Hobbyhobbit/BikeFromHell/README

see the project documentation which can be found at

http://people.ee.ethz.ch/~andstein/bfh/
