Hobbyhobbit/BikeFromHell/links.txt

color cycling
  - http://www.effectgames.com/demos/canvascycle/?sound=0

bluetooth modules
  - http://www.goodluckbuy.com/serial-bluetooth-rf-transceiver-module-rs232.html

SMD LEDs
  - unicolored, reichelt
