Hobbyhobbit/BikeFromHell/documentation/energy.rst

***************************
Energy/Power Considerations
***************************

Batteries
=========

  - `triple A batteries`_
    
    - up to 1200 mAh (Alkaline LR03, Lithium FR03)
    - relatively small discharge current

.. _triple A batteries: http://en.wikipedia.org/wiki/AAA_battery
