Hobbyhobbit/BikeFromHell/documentation/index.rst

.. Bike From Hell documentation master file, created by
   sphinx-quickstart on Sat Mar 10 12:53:52 2012.
   You can adapt this file completely to your liking, but it should at least
   contain the root `toctree` directive.

Bike From Hell Documentation
============================

This document describes various aspects of the project, such as information
on required hardware, implementation details, design guidelines etc...

.. toctree::
   :maxdepth: 3

   parts.rst
   speed.rst
   bluetooth.rst
   userinterface.rst
   prototypes.rst
   energy.rst
   notes.rst

TODO
====

.. todolist::
