Hobbyhobbit/BikeFromHell/artwork/prototype1_naked.jpg

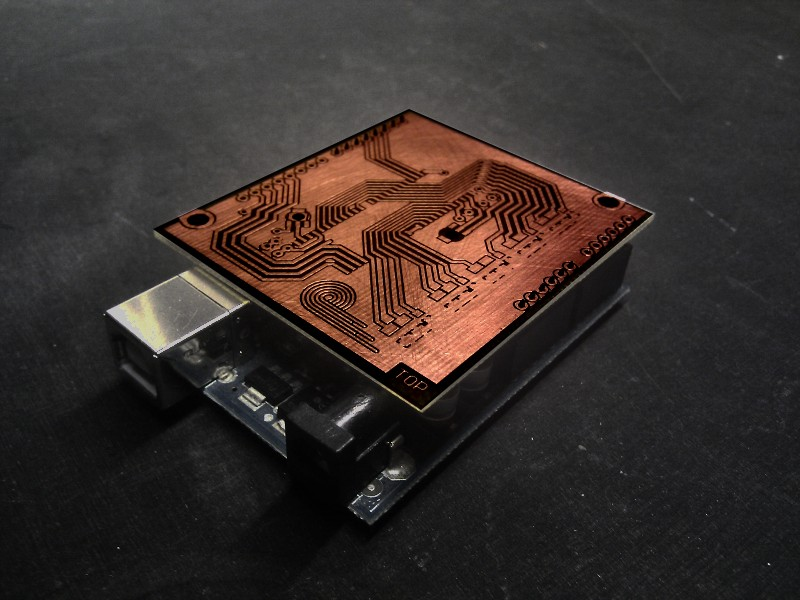
artwork/prototype1_naked.jpg
