Hobbyhobbit/BikeFromHell/sketches/BikeFromHell/patterns/eye.jpeg

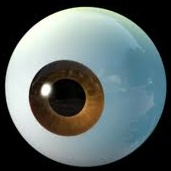
sketches/BikeFromHell/patterns/eye.jpeg
