Hobbyhobbit/BikeFromHell/sketches/BikeFromHell/patterns/nein_danke.gif

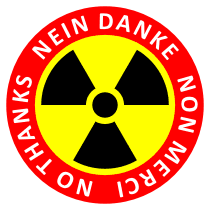
sketches/BikeFromHell/patterns/nein_danke.gif
