Hobbyhobbit/BikeFromHell/sketches/BikeFromHell/patterns/spectrum.png

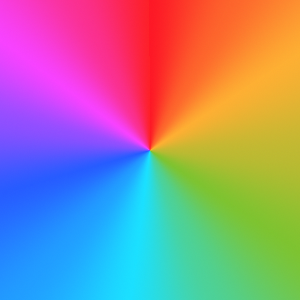
sketches/BikeFromHell/patterns/spectrum.png
