Hobbyhobbit/BikeFromHell/hardware/eagle/prototype1/Prototype1.pdf

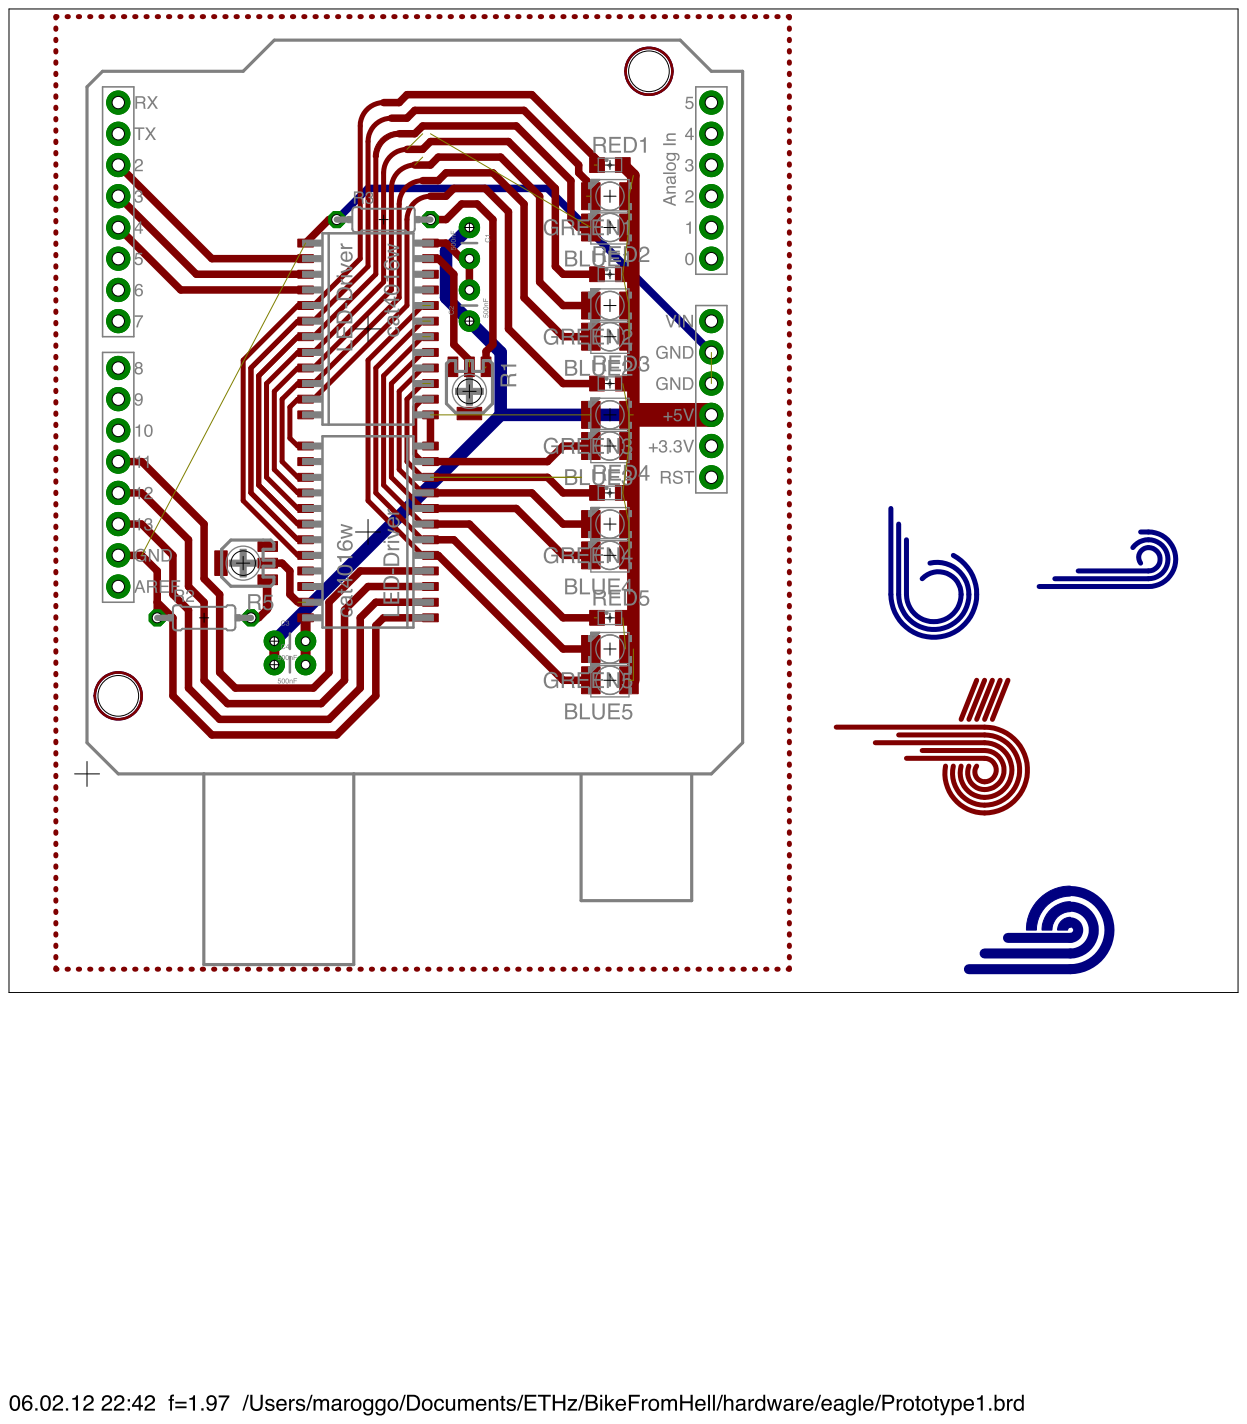
[picture p7: page 1]
