Hobbyhobbit/BikeFromHell/(list of files, drawings)

Other design files:
hardware/geda/prototooth/prototooth.pcb
hardware/geda/prototype3/b_lines_scaled.pcb
hardware/geda/prototype3/prototype3.pcb
hardware/geda/res/arduino-shield.pcb
