Hobbyhobbit/BikeFromHell/hardware/eagle/prototype2/Prototype2.brd

## EAGLE design hardware/eagle/prototype2/Prototype2.brd (2012-07-21)

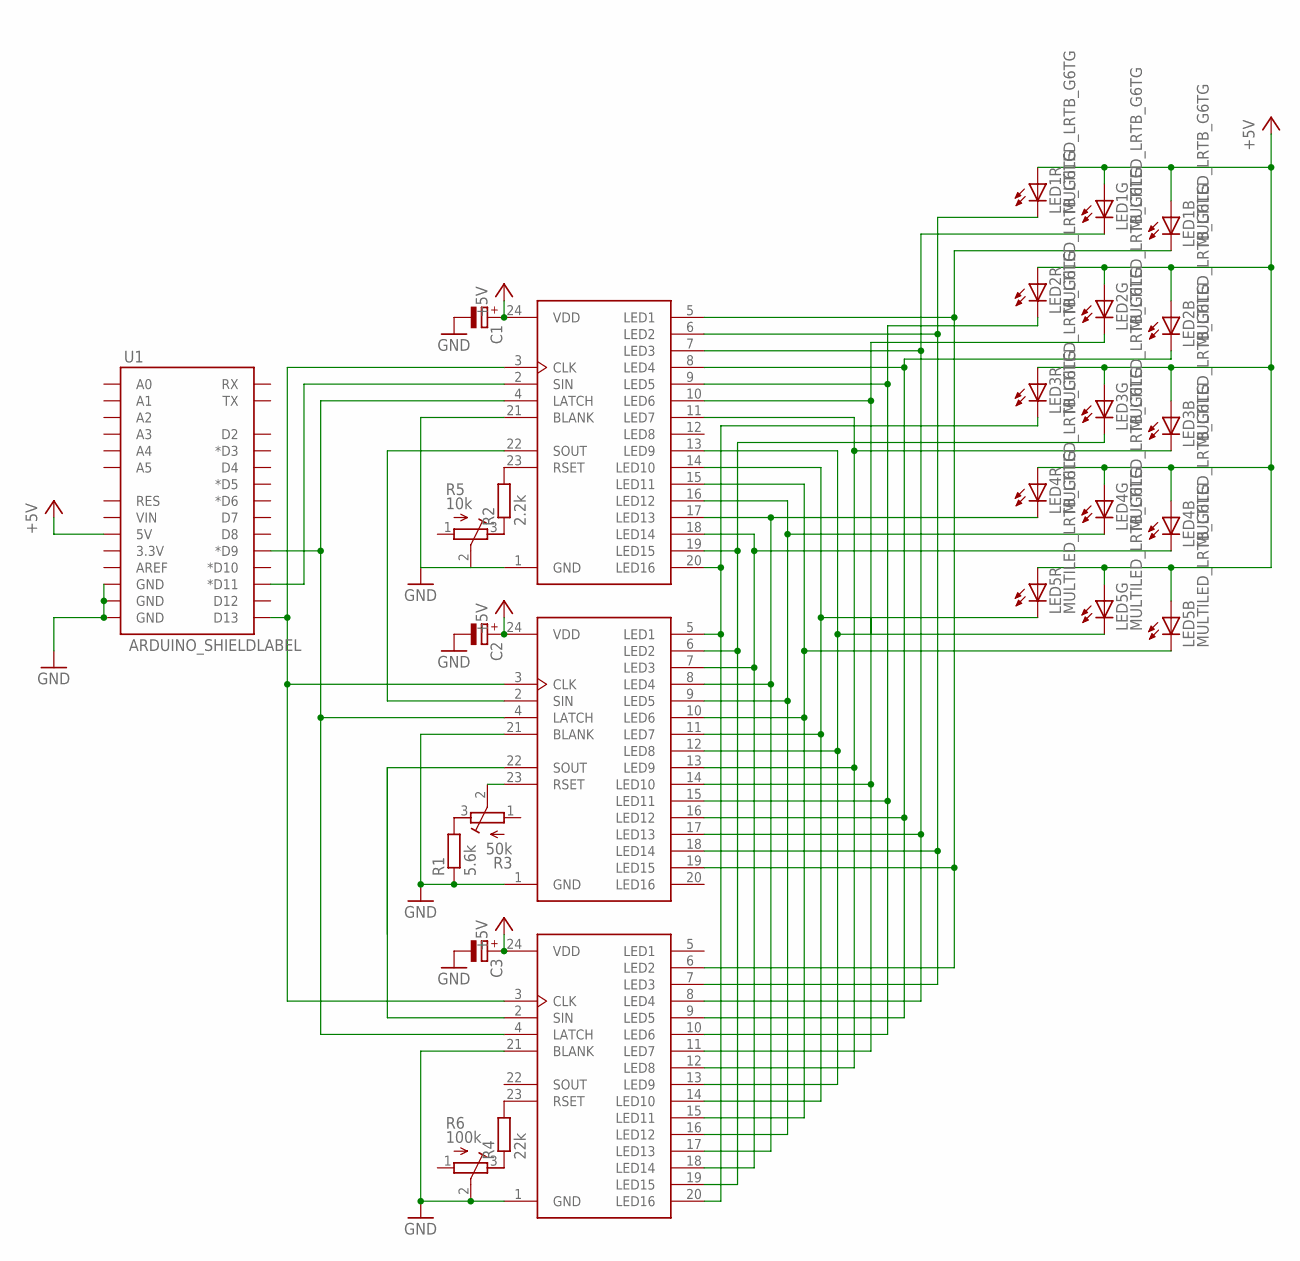
[picture p8: schematic Prototype2.sch]

Parts:
C1, C2, C3: CPOL-EUA/3216-18W; A/3216-18W
LED1, LED2, LED3, LED4, LED5: MULTILED_LRTB_G6TG; P-LCC-6_TOPLED
R1: 5.6k; 0204/7
R2: 2.2k; 0204/7
R3: 50k; RTRIM3165W
R4: 22k; 0204/7
R5: 10k; RTRIM3165W
R6: 100k; RTRIM3165W
U1: ARDUINO_SHIELDLABEL; DUEMILANOVE_SHIELD
U$1, U$2, U$3: CAT4016; SOIC24W

Connections:
+5V: C1.+, C2.+, C3.+, LED1.A1 (A), LED1.A2 (A), LED1.A3 (A), LED2.A1 (A), LED2.A2 (A), LED2.A3 (A), LED3.A1 (A), LED3.A2 (A), LED3.A3 (A), LED4.A1 (A), LED4.A2 (A), LED4.A3 (A), LED5.A1 (A), LED5.A2 (A), LED5.A3 (A), U1.5V, U$1.24 (VDD), U$2.24 (VDD), U$3.24 (VDD)
GND: C1.-, C2.-, C3.-, R1.1, R5.2 (S), R6.2 (S), U1.GND@0 (GND), U1.GND@1 (GND), U1.GND@2 (GND), U$1.1 (GND), U$1.21 (BLANK), U$2.1 (GND), U$2.21 (BLANK), U$3.1 (GND), U$3.21 (BLANK)
unnamed: R2.2, U$3.23 (RSET)
unnamed: R2.1, R5.3 (E)
unnamed: R4.2, U$2.23 (RSET)
unnamed: U$1.2 (SIN), U$3.22 (SOUT)
unnamed: U1.D11 (*D11), U$3.2 (SIN)
unnamed: U1.D9 (*D9), U$1.4 (LATCH), U$2.4 (LATCH), U$3.4 (LATCH)
unnamed: R4.1, R6.3 (E)
unnamed: R1.2, R3.3 (E)
unnamed: R3.2 (S), U$1.23 (RSET)
unnamed: U$1.22 (SOUT), U$2.2 (SIN)
unnamed: U1.D13, U$1.3 (CLK), U$2.3 (CLK), U$3.3 (CLK)
unnamed: LED5.C2 (C), U$1.12 (LED8), U$2.13 (LED9), U$3.13 (LED9)
unnamed: LED5.C1 (C), U$1.11 (LED7), U$2.14 (LED10), U$3.14 (LED10)
unnamed: LED5.C3 (C), U$1.10 (LED6), U$2.15 (LED11), U$3.15 (LED11)
unnamed: LED4.C2 (C), U$1.9 (LED5), U$2.16 (LED12), U$3.16 (LED12)
unnamed: LED4.C1 (C), U$1.8 (LED4), U$2.17 (LED13), U$3.17 (LED13)
unnamed: LED4.C3 (C), U$1.7 (LED3), U$2.18 (LED14), U$3.18 (LED14)
unnamed: LED3.C2 (C), U$1.6 (LED2), U$2.19 (LED15), U$3.19 (LED15)
unnamed: LED3.C3 (C), U$1.13 (LED9), U$2.12 (LED8), U$3.11 (LED7)
unnamed: LED2.C2 (C), U$1.14 (LED10), U$2.11 (LED7), U$3.10 (LED6)
unnamed: LED2.C1 (C), U$1.15 (LED11), U$2.10 (LED6), U$3.9 (LED5)
unnamed: LED2.C3 (C), U$1.16 (LED12), U$2.9 (LED5), U$3.8 (LED4)
unnamed: LED1.C2 (C), U$1.17 (LED13), U$2.8 (LED4), U$3.7 (LED3)
unnamed: LED1.C1 (C), U$1.18 (LED14), U$2.7 (LED3), U$3.6 (LED2)
unnamed: LED1.C3 (C), U$1.19 (LED15), U$2.6 (LED2), U$3.5 (LED1)
unnamed: LED3.C1 (C), U$1.5 (LED1), U$2.20 (LED16), U$3.20 (LED16)

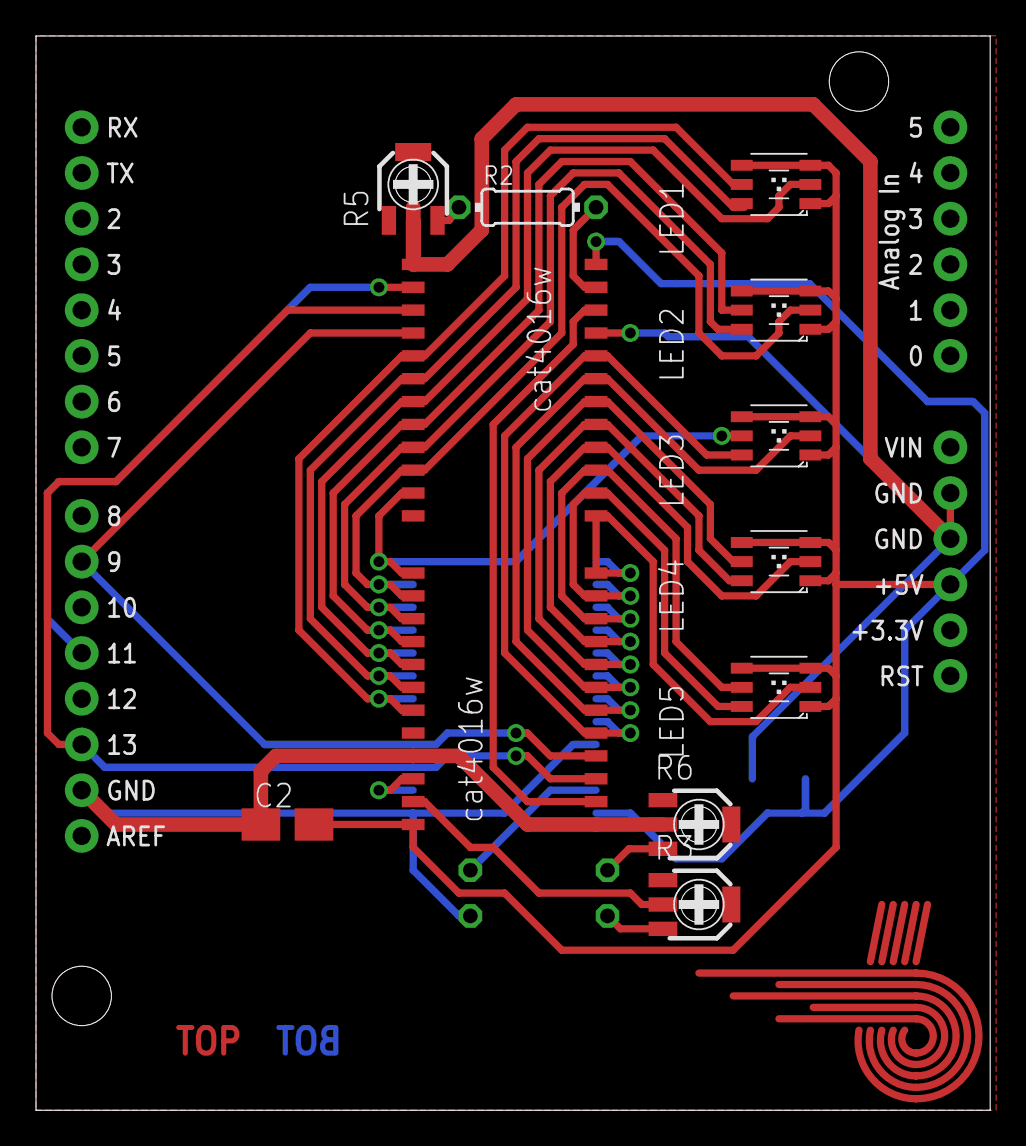
[picture p9: board Prototype2.brd from above]

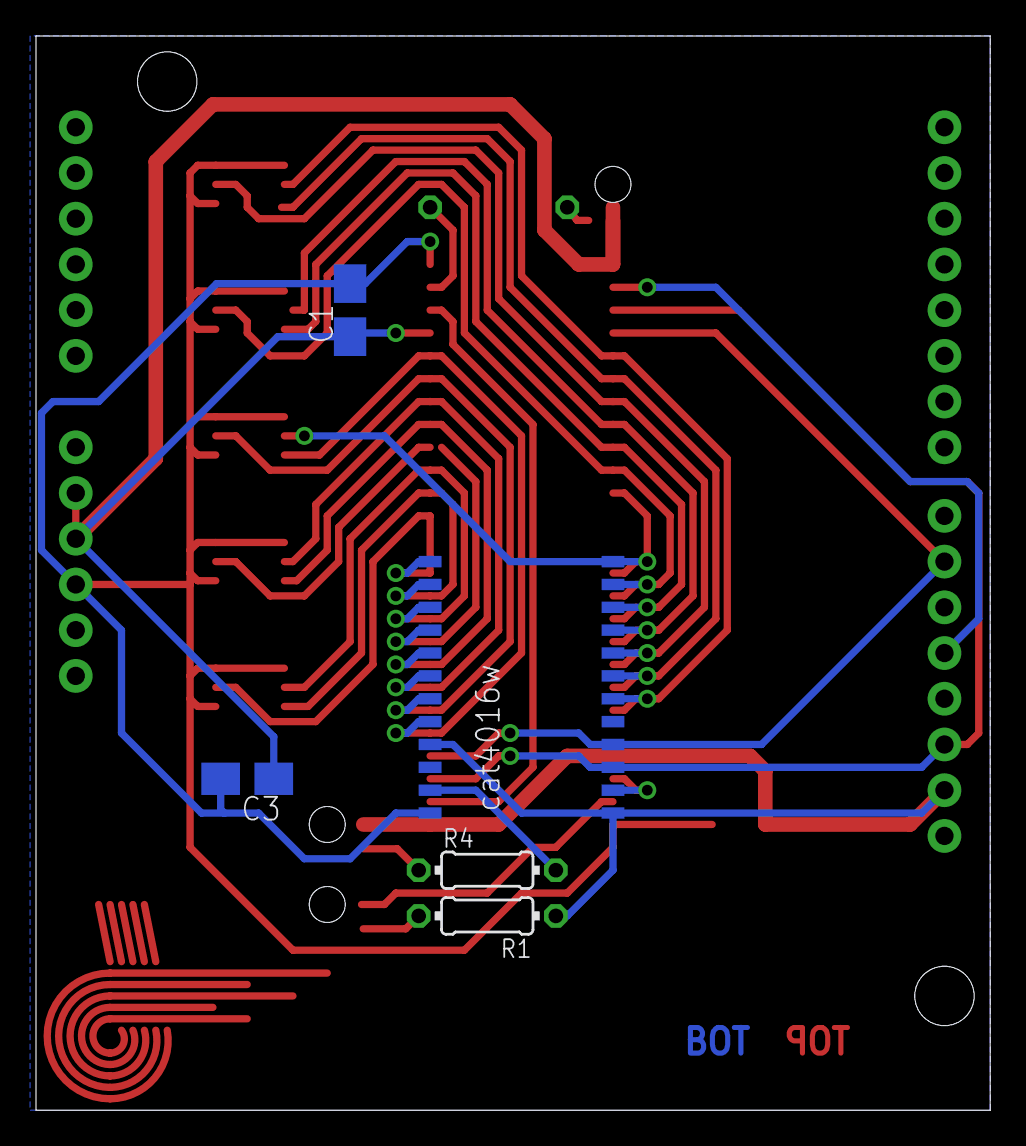
[picture p10: board Prototype2.brd from below]

Board: 2 copper layers, 53.0 x 59.7 mm, 18 parts (5 on the bottom side), 28 nets.
