Hobbyhobbit/BikeFromHell/hardware/eagle/prototype1/Prototype1.brd

## EAGLE design hardware/eagle/prototype1/Prototype1.brd (2012-02-19, an earlier design)

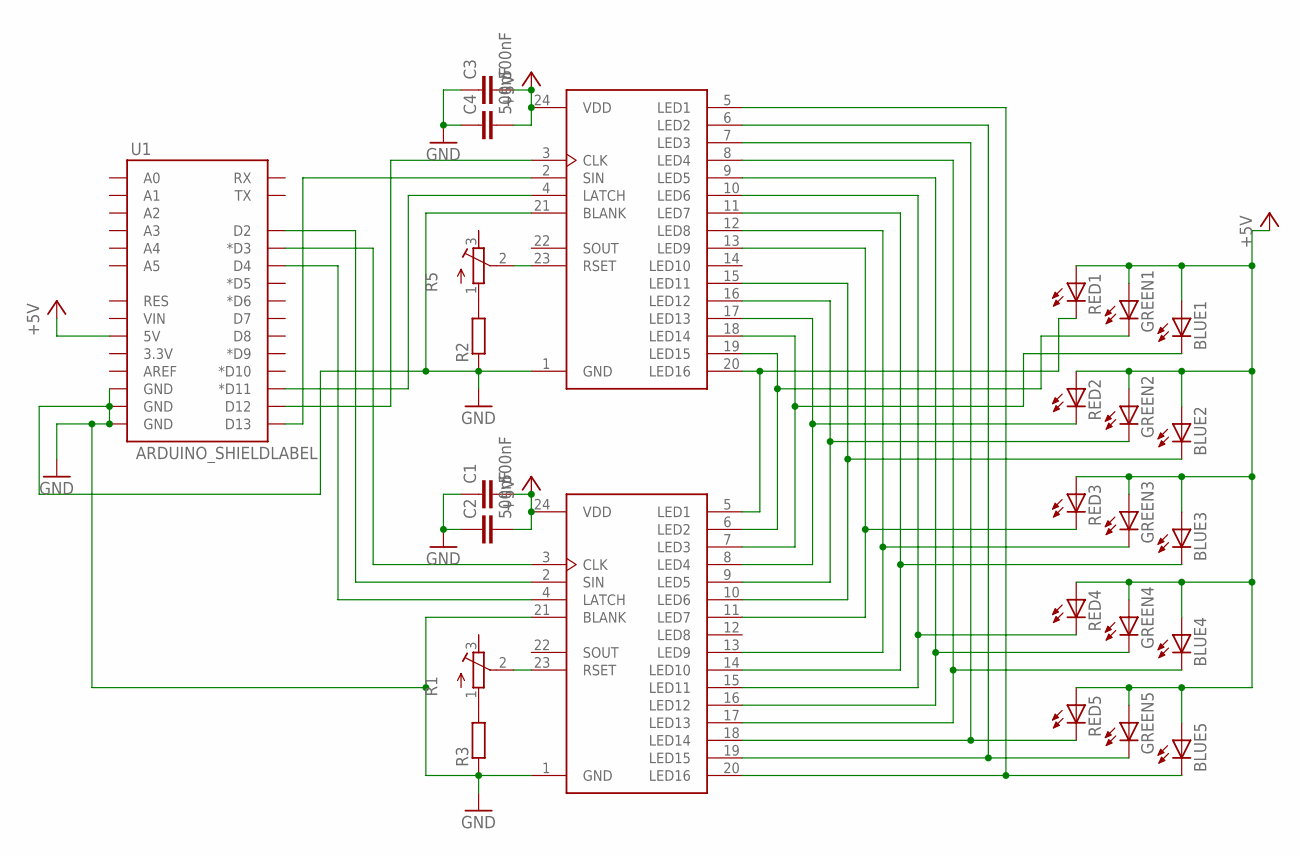
[picture p11: schematic Prototype1.sch]

Parts:
BLUE1, BLUE2, BLUE3, BLUE4, BLUE5: LEDKA-3528ASYC; KA-3528ASYC
C1, C2, C3, C4: 500nF; CAP-PTH-SMALL
GREEN1, GREEN2, GREEN3, GREEN4, GREEN5: LEDKA-3528ASYC; KA-3528ASYC
R1, R5: R-TRIMM3165W; RTRIM3165W
R2, R3: R-EU_0204/7; 0204/7
RED1, RED2, RED3, RED4, RED5: LEDSML0805; SML0805
U1: ARDUINO_SHIELDLABEL; DUEMILANOVE_SHIELD
U$2, U$3: CAT4016; SOIC24W

Connections:
+5V: BLUE1.A, BLUE2.A, BLUE3.A, BLUE4.A, BLUE5.A, C1.2, C2.2, C3.2, C4.2, GREEN1.A, GREEN2.A, GREEN3.A, GREEN4.A, GREEN5.A, RED1.A, RED2.A, RED3.A, RED4.A, RED5.A, U1.5V, U$2.24 (VDD), U$3.24 (VDD)
GND: C1.1, C2.1, C3.1, C4.1, R2.1, R3.1, U1.GND@0 (GND), U1.GND@1 (GND), U1.GND@2 (GND), U$2.1 (GND), U$2.21 (BLANK), U$3.1 (GND), U$3.21 (BLANK)
unnamed: R1.1 (A), R3.2
unnamed: R2.2, R5.1 (A)
unnamed: R1.2 (S), U$2.23 (RSET)
unnamed: R5.2 (S), U$3.23 (RSET)
unnamed: U1.D3 (*D3), U$2.3 (CLK)
unnamed: U1.D4, U$2.4 (LATCH)
unnamed: U1.D13, U$3.2 (SIN)
unnamed: U1.D2, U$2.2 (SIN)
unnamed: GREEN2.C, U$2.9 (LED5), U$3.16 (LED12)
unnamed: RED2.C, U$2.8 (LED4), U$3.17 (LED13)
unnamed: BLUE1.C, U$2.7 (LED3), U$3.18 (LED14)
unnamed: GREEN1.C, U$2.6 (LED2), U$3.19 (LED15)
unnamed: BLUE2.C, U$2.10 (LED6), U$3.15 (LED11)
unnamed: RED1.C, U$2.5 (LED1), U$3.20 (LED16)
unnamed: RED3.C, U$2.11 (LED7), U$3.13 (LED9)
unnamed: GREEN3.C, U$2.13 (LED9), U$3.12 (LED8)
unnamed: BLUE3.C, U$2.14 (LED10), U$3.11 (LED7)
unnamed: RED4.C, U$2.15 (LED11), U$3.10 (LED6)
unnamed: GREEN4.C, U$2.16 (LED12), U$3.9 (LED5)
unnamed: BLUE4.C, U$2.17 (LED13), U$3.8 (LED4)
unnamed: RED5.C, U$2.18 (LED14), U$3.7 (LED3)
unnamed: GREEN5.C, U$2.19 (LED15), U$3.6 (LED2)
unnamed: U1.D12, U$3.3 (CLK)
unnamed: U1.D11 (*D11), U$3.4 (LATCH)
unnamed: BLUE5.C, U$2.20 (LED16), U$3.5 (LED1)

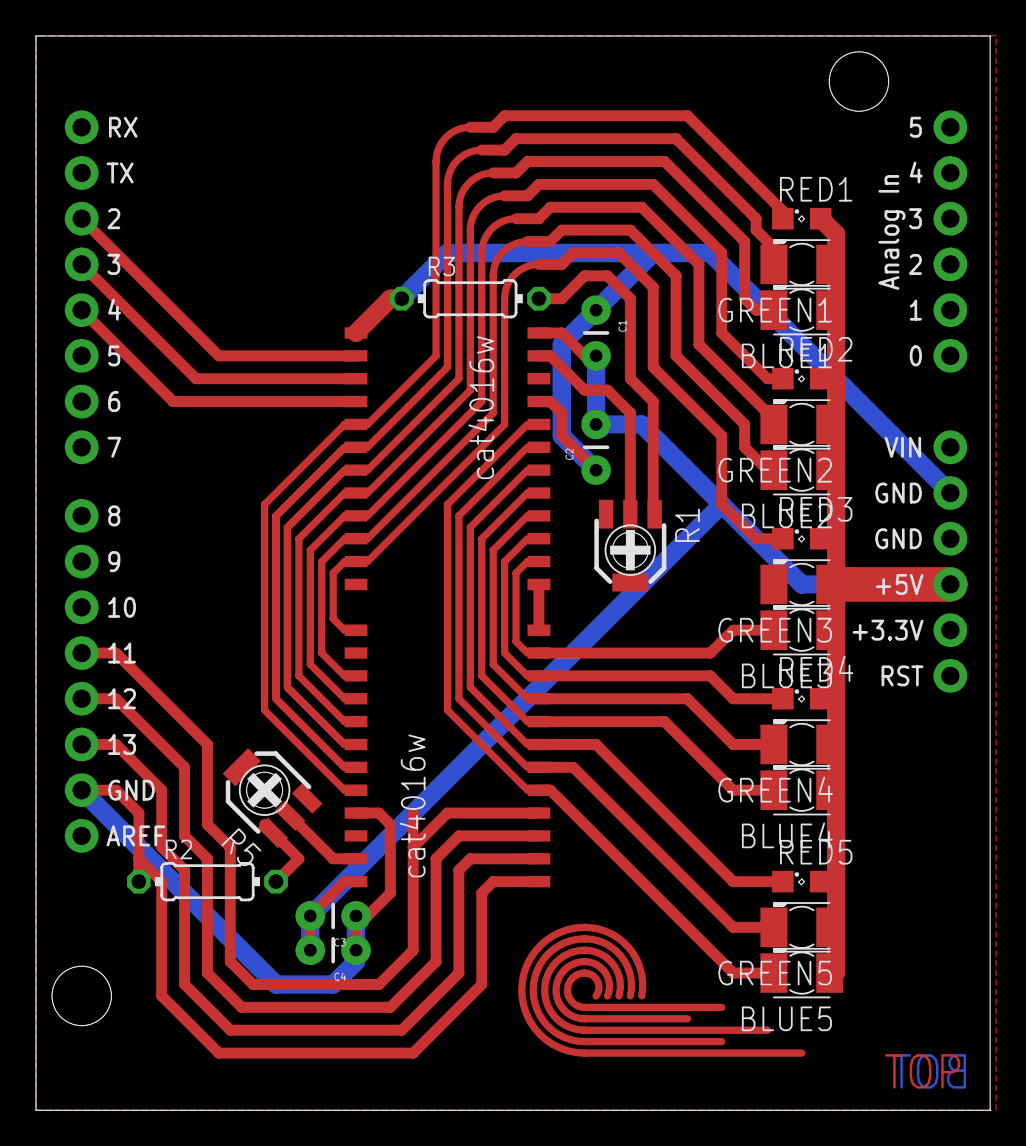
[picture p12: board Prototype1.brd from above]

Board: 2 copper layers, 53.0 x 59.7 mm, 26 parts (0 on the bottom side), 27 nets.
