Hobbyhobbit/BikeFromHell/sketches/BikeFromHell/BikeFromHell.pde

import controlP5.*;

int things= 1;
int leds= 5;
int resolution= 10; // slots per turn
//int leds= 16;
//int resolution= 100; // slots per turn
float kmh= 10f; // bicycle speed
float smear=.5f; // how long lights are visible
float wheelR=.4f; // wheel radius

final static int RUNNING= 0;
final static int IMAGING= 1;
int mode = RUNNING;
SpinningWheel spinningWheel;
ImageWheel    imageWheel;
Prototype1Serializer serializer;

float pos1= 0f, pos2= 0f; // grow continuously; +1/turn
float dpos= 0f; // adapted depending on actual fps
float delta= 0f;
int fps= 60; // will be adjusted to actual value
Textlabel fpsLabel;
int mstart,lastframe,frames;
ControlP5 cp5;
LedMatrix matrix;
int ledMax=4; // resolution of every LED; e.g. 4 means 2 bits
int ledRed,ledGreen,ledBlue; // active color in matrix

// create new .matrix files : press "d" and copy'n'paste into data/ directory
String[] dataFiles;

void setup() {
  size(800,400);
  cp5= new ControlP5(this);
  // general parameters
  cp5.addSlider("kmh"  ,0f,30f, 560,100,10,100);
  cp5.addSlider("smear",0f, 1f, 600,100,10,100);
  cp5.addSlider("delta",0f,.2f, 640,100,10,100);
  
  // file controls
  // won't work in applet
  File dataDir= new File(sketchPath+"/patterns");
  dataFiles = dataDir.list();

  ListBox fileList= cp5.addListBox("fileList", 680,100,100,200);
  for(int i=0; i<dataFiles.length; i++){
    if (dataFiles[i].charAt(0) != '.')
      fileList.addItem( dataFiles[i],i );
  }
  
  // color pickers
//  cp = new ColorPicker( 20, 60, 200, 200, 255 );
  colorSlider("ledRed"  ,#FF0000,  0,290,60,10);
  colorSlider("ledGreen",#00FF00, 80,290,60,10);
  colorSlider("ledBlue" ,#0000FF,160,290,60,10);
  
  // led matrix
  matrix= new LedMatrix("ledCode",ledMax,resolution,leds,0,300,800,100);
  
  // wheel controls
  fpsLabel= cp5.addTextlabel("fps","?? FPS",760,290);
  spinningWheel= new SpinningWheel( width/2,150,100,20,matrix );
  imageWheel   = new ImageWheel   ( width/2,150,100,20,matrix );
  
  // arduino connection
  serializer= new Prototype1Serializer();
  cp5.addButton("flash",0,700,290,50,10);

  frameRate(fps);
  mstart= millis();
  lastframe= frames= 0;
  
  background(0);
}


void draw() {
  // clear background of controls
  fill(0);
  rect(0  ,0,150,300);
  rect(650,0,150,300);
  
  if (mode == IMAGING) {
    background(0); // messy image scaling ;)
    imageWheel.draw();
    matrix.setInteract(false);
  }

  if (mode == RUNNING) {
    // calculate position
    pos1+= dpos;
    pos2+= dpos*(1+delta);
  
    spinningWheel.setPos(pos1);
    spinningWheel.setDelta(pos2-pos1);
    spinningWheel.draw();

    matrix.setPos(pos1);
    matrix.setInteract(true);
  }
  
  // draw matrix in both cases
//  cp.render();
  matrix.draw();
  
  // calculate frame count and do speed->pos conversion
  if (millis()-mstart>1000) {
    mstart= millis();
    fps= frames-lastframe;
    lastframe= frames;
    fpsLabel.valueLabel().set(fps + " FPS");
    dpos= 1f/fps * kmh/3.6/(2*PI*wheelR);
  }
  
  frames++;
}
