Hobbyhobbit/BikeFromHell/(commit log)

2012-02-01 LEDs can be changed on-the-fly; atom.matrix
    - setting dimensions from .matrix files
    - crushing colors to current setting
2012-02-02 added hardware/
    - eagle
    - geda : gschem/pcb files
    - datasheets
    also added links.txt for further reference
    [Schema.sch, arduino-shield.pcb, arduino-shield.sch, leds.sch]
2012-02-02 Board angefangen. Sehr kleine Leiter.
    [Prototype1.brd, Prototype1.sch, arduino_2009.brd, arduino_2009.sch]
2012-02-03 cat4016 hat nun kleine Füsse
    [Prototype1.brd, Prototype1.sch]
2012-02-04 Wege bahnen WIP
    [Prototype1.brd, Prototype1.sch]
2012-02-05 Prototyp 1 verkabelt
    [Prototype1.brd, Prototype1.sch]
2012-02-06 logo ideas
    [Prototype1.brd]
2012-02-07 fixed pours both sides; little logo
    [Prototype1.brd]
2012-02-07 finished Prototype1, created gerber
    [Prototype1.brd, Prototype1.sch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]
2012-02-17 peek preview of prototype board mounted on arduino
2012-02-25 playAround.ino: LEDs gemappt und ansteuerbar
2012-03-04 added SPI test arduino script & Makefile
    the Makefile must be edited for the local configuration
    and can be used to generate the temporary applet files;
    these are particularly interesting to see the actual
    implementation of the different provided arduino function
    for speed-debugging purposes...
2012-03-06 added OSX Arduino 1.0 Makefile
2012-03-07 new firmware that loads values from processing
    connect the shield to the USB and hit the "flash" button
    in the BikeFromHell sketch...
    (pre-alpha early release)
2012-03-07 temporary commit before merge
    [Prototype1.sch, arduino-shield.sch]
2012-03-07 Aufräumversuch prototypeverzeichnis
    [Prototype1.b#1.brd, Prototype1.b#2.brd, Prototype1.brd, Prototype1.sch, Prototype2.brd, Prototype2.sch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]
2012-03-11 prototype2: resistor values, partlist
    [Prototype2.brd, Prototype2.sch]
2012-03-12 Prototype2: Layout-update. doc: parts-list prototype 2
    [Prototype2.brd]
2012-03-12 Gerber files for updated Prototype2
    [Prototype2.brd]
2012-03-13 updated BikeFromHell/test_serial
    processing/firmware communication now works somewhat
    more stable (though not perfectly, yet)
    more changes
    - pulsedtr.py for resetting arduino via USB
    - artwork/logo_prototype2.{png,svg}
    - bluetooth.rst
    - sphinx todo extension
    - arduino/pin_mapper for determining the LED mapping
    [BikeFromHell.pde, handlers.pde, serializer.pde, test_serial.ino]
2012-04-06 temporary Colorpicker
    [Prototype2.brd]
2012-04-26 added new avr/ code
    this particularly contains a new interrupt driven protocol
    implementation; also added sketches/TestProtocol/ and changed
    sketches/BikeFromHell/serializer.pde (does not really work yet)
    beware that avr/ code is not "arduino compatible" anymore; this
    step was necessary to get the performance specifications we will
    need for the final implementation... prototyping can still be
    done with the arduino environment, though.
2012-05-13 simple protocol implementation\n\nusing ISR for fast transfer from UART
2012-05-13 updated arduino shield schematic/footprint (geda)
    [arduino-shield.pcb, arduino-shield.sch]
2012-05-13 added PCB footprint for bluetooth board & pfc.py
2012-05-13 simple pin mapper for prototype2
2012-07-03 updated documentation
    added datasheets for new LED, bluetooth module information,
    new LED driver
2012-07-03 cleanup in hardware/geda
    [leds.sch]
2012-07-03 added bluetooth arduino shield
    [prototooth.pcb, prototooth.sch]
2012-07-03 added draft of third prototype board
    [prototype3.sch]
2012-07-05 added 2nd TLC to prototype3
    also changed TLC symbol (moved XLAT next to serial interface pins)
    [prototype3.sch]
2012-09-05 updated prototype3.sch (hall, bt, connector)
    [prototype3.sch]
2012-09-05 started work on prototype3.pcb
    [prototype3.pcb]
2012-11-23 partially routed prototype3
    [prototype3.pcb]
2012-11-23 added test for parts in prototype3
    [protytpe3_test.pcb]
2012-11-24 almost finished prototype3.v1
    [prototype3.pcb]
2012-11-24 updated artwork; included logo into protoype3.v1
    also added brew compatible update.sh (commented by default)
    [b_lines_scaled.pcb, prototype3.pcb, prototype3.sch]
2012-11-24 added gerber files protoype3v1
    [prototype3.bottom.gbr, prototype3.outline.gbr, prototype3.top.gbr]
2012-11-26 corrected some DRC violations prototype3v1
    [prototype3.pcb, prototype3.sch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]
2013-01-27 P3: Test SPI
2014-10-28 switched signals gsclk (oc1a->clko) / blank (clko->oc1a) on prototype3
    [prototype3.pcb, prototype3.sch]
2014-11-05 Fixed TLC-Prototype
2014-11-06 added compiled footprints
    [protytpe3_test.pcb]
